SmallWhitedawsd/pulse-laser-control/README.md

# 脉冲激光控制模块

> STM32F103C8T6 实时脉冲选通器 — 从连续脉冲串中选取 N 个脉冲输出，组间延时可调。

---

## 1. 概述

本模块接收外部 **1KHz ~ 100KHz TTL 脉冲信号**，通过实时门控逻辑，按设定数量（N）选通每组脉冲，并在组间插入可调的静音延时（T）。参数通过串口设置，掉电自动保存。

### 核心功能

1. **脉冲可选（N）**：从连续脉冲串中选取 1 ~ 65535 个脉冲输出
2. **延时可调（T）**：每组脉冲之间插入 1 ~ 50000 ms 低电平静音
3. **实时跟随**：输出波形完整复制输入脉宽，输入→输出延迟 ~2μs

---

## 2. 硬件规格

| 项目 | 参数 |
|---|---|
| MCU | STM32F103C8T6 (Cortex-M3, 72MHz, 64KB Flash, 20KB SRAM) |
| 输入引脚 | **PA0** — 3.3V TTL, 内部下拉 ~10KΩ |
| 输出引脚 | **PA1** — 3.3V TTL, 推挽 50MHz, 100Ω 串联保护 |
| 串口 | **USART1** — PA9(TX) / PA10(RX), 115200-8N1 |
| USB | CH340N (Type-C) |
| 调试 | SWD — PA13(SWDIO) / PA14(SWCLK) |
| PCB | 50×25mm 直插式 |

---

## 3. 输入信号参数

| 参数 | 最小值 | 最大值 | 单位 | 说明 |
|---|---|---|---|---|
| 高电平电压 | 2.0 | 3.6 | V | TTL VIH |
| 低电平电压 | 0 | 0.8 | V | TTL VIL |
| 脉冲频率 | 1 | 100 | kHz | 周期 10μs ~ 1ms |
| 最小高电平脉宽 | 1.4 | — | μs | TIM2 @72MHz 约 100 ticks |
| 最大高电平脉宽 | — | ~910 | μs | 16 位定时器上限 |
| 输入阻抗 | — | ~10 | kΩ | 内部下拉 |

---

## 4. 输出信号参数

| 参数 | 值 | 说明 |
|---|-----|---|
| 高电平电压 | 3.3V (VOH ≥3.0V) | 推挽输出 |
| 低电平电压 | 0V (VOL ≤0.1V) | 推挽输出 |
| 输入→输出延迟 | **~2μs** | TIM2 ISR 内直驱 GPIO |
| 输出脉宽 | **= 输入脉宽** | 实时跟随，完整保留 |
| 驱动能力 | ≤25mA | 单 IO 最大 |

---

## 5. 可控参数

| 参数 | 缩写 | 范围 | 默认值 | 精度 | 说明 |
|---|---|---|---|---|---|
| 每组脉冲数 | **N** | 1 ~ N<sub>max</sub> | 2 | 1 个 | N<sub>max</sub> = 输入频率(Hz)，保证每组 ≤1 秒；无信号回退 65535 |
| 组间延时 | **T** | 1 ~ 50000 | 2 | 1 ms | 每组之间的低电平时间 |

> **N 动态上限：** TIM2 实时测量输入频率，N 最大值 = 频率值（Hz）。100KHz → N<sub>max</sub>=100000，1KHz → N<sub>max</sub>=1000。频率测量使用 32 位时间戳（TIM2 溢出中断累计），除法在主循环执行，不阻塞 ISR。

---

## 6. 串口指令

波特率 **115200**, 8 数据位, 1 停止位, 无校验, 无流控。命令以 `\r` 或 `\n` 结尾。

| 命令 | 功能 | 示例 |
|---|---|---|
| `N=<1~Nmax>` | 设置脉冲数 + 保存，上限随输入频率动态变化 | `N=5` |
| `T=<1~50000>` | 设置延时(ms) + 保存 | `T=10` |
| `N=<n> T=<t>` | 同时设置两个参数 + 保存 | `N=5 T=10` |
| `STATUS?` | 查询输入频率、当前 N/T 及 N 上限 | `STATUS?` |

### 命令响应示例

```
→ N=5 T=1
← OK N=5 T=1ms

→ STATUS?
← Fin=10000Hz N=5/10000 T=1ms   ← 10KHz 输入时 N 最大 10000

→ T=50
← OK N=5 T=50ms

→ N=20000                        ← 超过当前频率的 N 上限
← ERR N RANGE (1~10000)          ← 10KHz 输入限制 N≤10000

→ T=0
← ERR T RANGE (1~50000)
```

---

## 7. 波形示意

输入 1KHz 50% 占空比，N=2，T=1ms：

```
输入:  _|‾|_|‾|_|‾|_|‾|_|‾|_|‾|_
输出:  _|‾|_|‾|___|‾|_|‾|___|‾|_|‾|___
        p1  p2  静音 p1  p2  静音
       ← N=2 →       ← N=2 →
              ←T=1ms→       ←T=1ms→
```

---

## 8. 技术实现

### 架构

```
PA0 (输入脉冲) ──→ TIM2 双沿捕获 ──→ 实时门控状态机 ──→ PA1 (输出)
                       │                    │
                  13.9ns 分辨率        S_FORWARD: 跟随
                                      S_SILENCE: 静音 (TIM3 1ms 计时)
```

- **TIM2 ISR**：最高优先级 (0,0)，捕获 PA0 边沿，直接控制 PA1 翻转，延迟 ~2μs；同时累计溢出计数器构建 32 位时间戳，测量输入频率（ISR 内零除法开销）
- **TIM3 ISR**：优先级 (1,0)，每 1ms 溢出一次，递减静音计数器
- **主循环**：执行频率除法 `72000000/period`（Output_Poll），响应串口命令（Cmd_Poll）
- **USART1 ISR**：优先级 (2,0)，接收串口命令

### 存储

- 地址：Flash 第 63 页 `0x0800FC00`
- 内容：`burst_count` (4B) + `burst_delay` (4B)
- 首次上电：擦除态 `0xFFFFFFFF` → 使用默认值 N=2, T=2
- 触发保存：每次 `N=` 或 `T=` 命令

---

## 9. 编译与烧录

| 工具 | 版本/型号 |
|---|---|
| IDE | Keil MDK-ARM V5 |
| 库 | STM32F10x 标准外设库 V3.5.0 |
| 编译器 | ARM Compiler V5 |
| 烧录器 | ST-Link V2 / J-Link（SWD 接口） |

---

## 10. 项目结构

```
脉冲激光控制模块/
├── 脉冲激光控制模块代码/        # ← 当前版本（实时门控）
│   ├── Hardware/
│   │   ├── output.c/h           # 脉冲门控核心
│   │   ├── serial.c/h           # 串口驱动
│   │   ├── cmd.c/h              # 命令解析
│   │   ├── config.c/h           # Flash 存储
│   │   └── capture.c/h          # 保留接口
│   ├── Library/                 # STM32F10x 标准外设库
│   ├── Start/                   # 启动文件
│   └── User/                    # main.c
├── 脉冲发生器代码/               # ← 旧版（PWM 发生器，参考）
├── 上位机/                       # Python 上位机脚本
├── 0 - 客户原文.txt
├── 1 - 功能介绍.txt
├── 2 - 实现方案.md
└── 3 - 硬件选型.md
```

---

## 11. 版本历史

| 版本 | 日期 | 内容 |
|---|---|---|
| v1.0 | 2026-06-01 | 初始版本：实时门控，N/T 参数 |
| v1.1 | 2026-06-07 | 修复 TIM3 PSC 溢出、FIFO_TAG_GAP、输出 LOW 间隔 |
| v1.2 | 2026-06-08 | 修复 TIM2 16 位翻转脉宽计算、编译错误 |
| v1.3 | 2026-06-13 | 修复 5 个 Bug：静音后 CC1P 重同步、volatile 缺失、Flash 写入 TIM3 漂移、Output_Resync 停止 TIM3、删除死代码 fifo.h |
| v1.4 | 2026-06-13 | N 上限动态调整：TIM2 32 位时间戳测频 → N<sub>max</sub>=输入频率(Hz)；除法在主循环，ISR 零开销 |
