SmallWhitedawsd/pulse-laser-control/脉冲激光控制模块代码/README.md

# 脉冲激光控制模块

基于 STM32F103C8T6 的实时脉冲选通器。接收外部 1KHz~100KHz 脉冲信号，按设定数量输出每组脉冲，每组之间延时可调。

## 硬件

| 项目 | 参数 |
|---|---|
| MCU | STM32F103C8T6 (Cortex-M3, 72MHz) |
| 输入引脚 | PA0 (3.3V TTL, 内部下拉 ~10KΩ) |
| 输出引脚 | PA1 (3.3V TTL, 推挽 50MHz, 100Ω 串联保护) |
| 串口 | USART1, PA9(TX)/PA10(RX), 115200-8N1 |
| USB 芯片 | CH340N (Type-C) |
| 调试 | SWD (PA13/PA14) |
| 保护 | 输出 100Ω 限流，防外部短路 |

---

## 输入信号规格

| 参数 | 符号 | 最小值 | 典型值 | 最大值 | 单位 | 说明 |
|---|---|---|---|---|---|---|
| 高电平电压 | VIH | 2.0 | 3.3 | 3.6 | V | TTL 高电平判决门限 |
| 低电平电压 | VIL | 0 | 0 | 0.8 | V | TTL 低电平判决门限 |
| 输入频率 | Fin | 1 | — | 100 | kHz | 连续脉冲串，周期 10μs ~ 1ms |
| 最小高电平脉宽 | Tw_min | 1.4 | — | — | μs | 低于此值可能捕获不到（72MHz 下约 100 个计数） |
| 最大高电平脉宽 | Tw_max | — | — | ~910 | μs | 16 位定时器 @72MHz 上限 (65535/72) |
| 输入阻抗 | Rin | — | 10 | — | kΩ | 内部下拉电阻 |

> TIM2 捕获时钟 72MHz，每个 tick = 13.9ns，分辨率足以覆盖 1KHz~100KHz 范围。

---

## 输出信号规格

| 参数 | 符号 | 最小值 | 典型值 | 最大值 | 单位 | 说明 |
|---|---|---|---|---|---|---|
| 高电平电压 | VOH | 3.0 | 3.3 | 3.3 | V | 推挽输出 |
| 低电平电压 | VOL | 0 | 0 | 0.1 | V | 推挽输出 |
| 输入→输出延迟 | Td | — | ~2 | ~5 | μs | TIM2 ISR 入口 → GPIO 翻转 |
| 输出驱动能力 | Iout | — | — | 25 | mA | 单 IO 最大电流 |
| 高电平脉宽 | Tw_out | — | = 输入脉宽 | — | — | 实时跟随，输出脉宽 = 输入脉宽 |

> 输出采用 TIM2 ISR 内直驱 GPIO，不经过 FIFO/主循环，延迟仅 ~2μs（远低于 100KHz × 5 周期 = 50μs 约束）。

---

## 可控参数

| 参数 | 缩写 | 范围 | 默认值 | 精度 | 说明 |
|---|---|---|---|---|---|
| 每组脉冲数 | N | 1 ~ N<sub>max</sub> | 2 | 1 个脉冲 | N<sub>max</sub> = 输入频率(Hz)，保证每组 ≤1 秒；无信号回退 65535 |
| 组间延时 | T | 1 ~ 50000 | 2 | 1 ms | 每组脉冲之间的低电平静音时间 |
| 输入频率 | — | 1KHz ~ 100KHz | — | — | TIM2 32 位时间戳实时测量，STATUS? 可查 |

> **N 动态上限：** TIM2 ISR 用溢出中断累计 32 位时间戳，主循环做 `72000000/period` 除法算出频率。100KHz → N<sub>max</sub>=100000，1KHz → N<sub>max</sub>=1000。ISR 内零除法开销，不影响输出波形。

---

## 工作原理

```
外部信号 → PA0(TIM2 双沿捕获) → 实时门控 → PA1 输出
                                   │
                          ┌────────┘
                          │ 计 N 个上升沿
                          │ 第 N 个下降沿后关门
                          │ 延时 T ms 后开门
```

TIM2 捕获 PA0 上升/下降沿，ISR 内直接控制 PA1 电平：
- **门开时（S_FORWARD）**：PA1 实时跟随 PA0（延迟 ~2μs），每捕捉一个上升沿脉冲计数+1；第 N 个脉冲的下降沿后关门
- **门关时（S_SILENCE）**：PA1 保持低电平，TIM3 计数 T ms 后重新开门

---

## 串口指令

所有指令以 `\r` 或 `\n` 结尾，大小写不敏感。

| 命令 | 功能 | 示例 | 响应 |
|---|---|---|---|
| `N=<count> T=<ms>` | 同时设置脉冲数和延时，自动保存 | `N=5 T=1` | `OK N=5 T=1ms` |
| `N=<count>` | 只设置脉冲数，自动保存 | `N=3` | `OK N=3 T=1ms` |
| `T=<ms>` | 只设置延时，自动保存 | `T=10` | `OK N=3 T=10ms` |
| `STATUS?` | 查询输入频率、N/T 及 N 上限 | `STATUS?` | `Fin=10000Hz N=3/10000 T=10ms` |

### 错误响应

| 响应 | 含义 |
|---|---|
| `ERR N RANGE (1~<max>)` | N 值超出动态范围，`<max>` = 当前输入频率(Hz) |
| `ERR T RANGE (1~50000)` | T 值超出范围 |

> **注意：** 每次 `N=` 或 `T=` 命令都会自动保存到 Flash（0x0800FC00），掉电不丢失。Flash 写入约需 20ms，期间不响应串口。

### 示例

```
发送: N=5 T=1
回复: OK N=5 T=1ms

发送: STATUS?
回复: Fin=10000Hz N=5/10000 T=1ms     ← 10KHz 输入，N 最大 10000

发送: N=3
回复: OK N=3 T=1ms

发送: T=50
回复: OK N=3 T=50ms

发送: N=20000                          ← 超过频率上限
回复: ERR N RANGE (1~10000)
```

---

## 波形示意

输入 1KHz 50% 占空比，N=2，T=1ms：

```
输入:  _|‾|_|‾|_|‾|_|‾|_|‾|_|‾|_
输出:  _|‾|_|‾|___|‾|_|‾|___|‾|_|‾|___
        p1  p2 静音  p1  p2 静音
       ← N=2 →         ← N=2 →
              ← T=1ms →       ← T=1ms →
```

输入 1KHz 50% 占空比，N=3，T=5ms：

```
输入:  _|‾|_|‾|_|‾|_|‾|_|‾|_|‾|_|‾|_
输出:  _|‾|_|‾|_|‾|_____|‾|_|‾|_|‾|_____
        p1  p2  p3 静音  p1  p2  p3 静音
       ←  N=3  →          ←  N=3  →
                   ← T=5ms →        ← T=5ms →
```

---

## 定时器与中断

| 定时器 | 时钟 | 周期 | 用途 | 抢占优先级 | 子优先级 |
|---|---|---|---|:---:|:---:|
| TIM2 | 72MHz /1 | 65535 ticks | 输入脉冲双沿捕获 + 溢出累计(32位时间戳测频) | 0 | 0 |
| TIM3 | 72MHz /72 | 1000 ticks | 组间延时计时，1ms 精度 | 1 | 0 |
| USART1 | — | — | 串口命令接收 | 2 | 0 |

> TIM2 同时开启 CC1 和 Update 两个中断：CC1 捕获边沿控制输出，Update 累计 `tim2_ovf32` 构建 32 位时间戳。频率除法 `72000000/period` 在 `Output_Poll()`（主循环）中执行，ISR 零除法开销。

---

## Flash 存储

| 地址 | 内容 | 说明 |
|---|---|---|
| `0x0800FC00` | `burst_count` (4B) | 脉冲数 N，擦除态 `0xFFFFFFFF` → 使用默认值 2 |
| `0x0800FC04` | `burst_delay` (4B) | 延时 T (ms)，擦除态 `0xFFFFFFFF` → 使用默认值 2 |

- 存储页：第 63 页（最后 1KB）
- 写入触发：每次 `N=` 或 `T=` 命令
- 寿命：STM32F1 Flash ≥10,000 次擦写

---

## 编译

- **IDE**: Keil MDK-ARM V5
- **库**: STM32F10x 标准外设库 V3.5.0
- **编译器**: ARM Compiler V5
- **烧录**: ST-Link / J-Link（SWD: PA13/PA14）

---

## 文件结构

```
脉冲激光控制模块代码/
├── Hardware/
│   ├── output.c / output.h    # 脉冲门控核心（TIM2/TIM3 ISR + 状态机）
│   ├── serial.c / serial.h    # USART1 串口驱动（115200-8N1）
│   ├── cmd.c / cmd.h          # 命令解析（N= / T= / STATUS?）
│   ├── config.c / config.h    # Flash 持久化配置
│   └── capture.c / capture.h  # 保留接口（未使用）
├── Library/                    # STM32F10x 标准外设库
├── Start/                      # 启动文件 + 系统时钟
└── User/
    ├── main.c                  # 主函数
    ├── stm32f10x_conf.h       # 外设配置头
    └── stm32f10x_it.c/h       # 异常向量表
```
