SmallWhitedawsd/pulse-laser-control/3 - 硬件选型.md

### 第一部分：Type-C 母座的连线

1. **VBUS 引脚**：连到 5V 电源线上去（也就是连到稳压芯片的输入端）。✅
2. **GND 引脚**：连到板子的地线。✅
3. **CC1 引脚**：连一个 5.1K 的电阻，电阻的另一头接地。✅
4. **CC2 引脚**：连另一个独立的 5.1K 的电阻，电阻的另一头接地。（千万别和 CC1 共用电阻）✅
5. **DP1 和 DP2 引脚**：这两个脚短接在一起，连到 **CH340N 的第 1 脚 (UD+)**。✅
6. **DN1 和 DN2 引脚**：这两个脚短接在一起，连到 **CH340N 的第 2 脚 (UD-)**。✅
7. **SBU1 和 SBU2 引脚**：空着，什么都不用连。✅

### 第二部分：CH340N 串口芯片的连线 (配合 3.3V 系统)

1. **第 5 脚 (VCC) 和 第 8 脚 (V3)**：这两个脚连在一起，全都接到 3.3V 电源上。✅
2. **第 3 脚 (GND)**：连到板子的地线。✅
3. **第 1 脚 和 第 2 脚**：分别接刚才 Type-C 引过来的 DP (D+) 和 DN (D-) 数据线。✅
4. **第 6 脚 (TXD)**：连到单片机的 **PA10 (RX)** 引脚。✅
5. **第 7 脚 (RXD)**：连到单片机的 **PA9 (TX)** 引脚。✅
6. **第 4 脚 (RTS#)**：空着，不用连。✅

### 第三部分：STM32 单片机的核心连线

1. **PA9 (TX)**：连到 CH340N 的 **第 7 脚 (RXD)**。✅
2. **PA10 (RX)**：连到 CH340N 的 **第 6 脚 (TXD)**。✅
3. **PA0**：连你的脉冲输入信号，同时在这个脚上接一个 10K 的电阻，电阻另一头接地。✅
4. **PA1**：连你的脉冲输出设备。✅
5. **四个 VDD 电源脚**（9脚、24脚、36脚、48脚）：全都连到 3.3V，每个脚旁边必须放一个 0.1uF 的小电容接地。✅
6. **四个 VSS 地线脚**（8脚、23脚、35脚、47脚）：全都连到地线。✅
7. **BOOT0 脚 和 BOOT1（PB2）脚**：各接一个 10K 电阻接地。✅
8. **VBAT (1脚)**：连到 3.3V。✅
9. **外部 8MHz 晶振**：晶振两端分别连第 5 脚 (OSC_IN) 和 第 6 脚 (OSC_OUT)，并且在这两个脚上各接一颗 22pF 电容到地线。✅
10. **SWD 程序烧录接口**：准备一个 4 针排针，第 34 脚 (PA13) 连 SWDIO，第 37 脚 (PA14) 连 SWCLK。排针另外两根连 3.3V 和 GND。✅

### 第四部分：BNC 脉冲输入接口连线 (BNC-KYWE-295-W4-N)

1. **第 5 脚 (中心信号线)**：直接连到单片机的 **PA0** 引脚。✅
2. **10K 防抖下拉电阻**：一头连在 **PA0 (或 BNC 的第 5 脚)**，另一头连到 **地线 (GND)**。（在物理走线上，这三者交汇在同一个节点）。✅
3. **第 1、2、3、4 脚 (外壳屏蔽脚)**：全部连到板子的 **地线 (GND)**。为了发挥最佳的高频抗干扰屏蔽效果，建议在这4个引脚的焊盘处直接打大过孔，牢牢连入底层的地铜网络。✅

### 第五部分：脉冲输出端子连线 (WJ500V-5.08-2P) 

1. **Pin 1 (输出信号)**：连到单片机的 PA1 引脚。引脚和端子之间串联一颗 100Ω 贴片电阻，防止外部设备短路烧毁单片机。✅
2. **Pin 2 (公共地)**：连到板子的 地线 (GND)。✅
