SmallWhitedawsd/pulse-laser-control/功能系统图.jpg

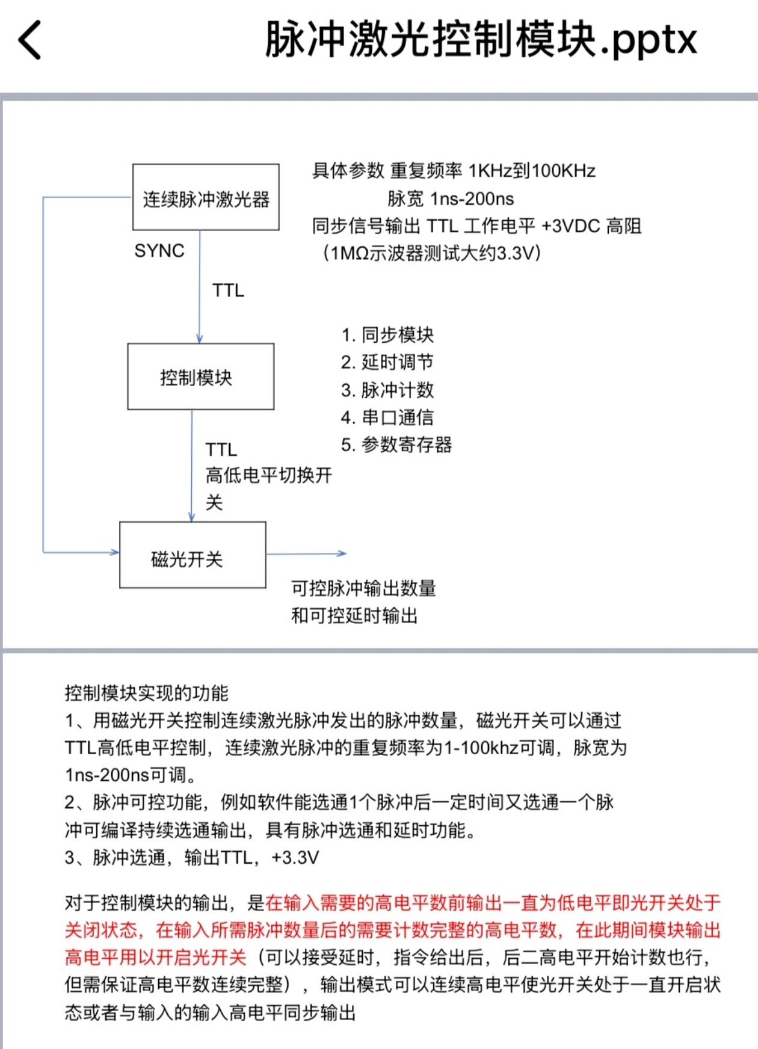
功能系统图.jpg
