SmallWhitedawsd/pulse-laser-control/BOM_Board1_Schematic1_2026-06-01.xlsx

No. | Quantity | Comment | Designator | Footprint | Value | Manufacturer Part | Manufacturer | Supplier Part | Supplier | 金额 |  | 数量
1 | 2 | 100nF | C2,C4 | C0603 | 100nF | CL10B104KB8NNNC | SAMSUNG(三星) | C1591 | LCSC |  | 有
2 | 1 | 10uF | C3 | C0603 | 10uF | CL10A106KP8NNNC | SAMSUNG(三星) | C19702 | LCSC |  | 有
3 | 4 | 100nF | C5,C6,C7,C8 | C0603 | 100nF | GRM188R71H104KA93D | muRata(村田) | C77055 | LCSC |  | 有
4 | 2 | 22pF | C11,C12 | C0603 | 22pF | CL10C220JB8NNNC | SAMSUNG(三星) | C1653 | LCSC |  | 有
5 | 1 | ZX-XH2.54-4PWZ | H2 | CONN-TH_4P-P2.50_ZX-XH2.54-4PWZ |  | ZX-XH2.54-4PWZ | Megastar(兆星) | C7429643 | LCSC |  | 不用买
6 | 1 | WJ500V-5.08-2P | P1 | CONN-TH_2P-P5.00_WJ500V-5.08-2P |  | WJ500V-5.08-2P | KANGNEX(康奈克斯电气) | C8465 | LCSC | 3.38 |  | 10
7 | 2 | 5.1kΩ | R1,R2 | R0603 | 5.1kΩ | 0603WAF5101T5E | UNI-ROYAL(厚声) | C23186 | LCSC | 3 |  | 100
8 | 3 | 10kΩ | R3,R4,R5 | R0603 | 10kΩ | FRC0603J103 TS | FOJAN(富捷) | C2930027 | LCSC |  | 有
9 | 1 | 3GHz | RF1 | BNC-TH_BNC-KYWE-295-W4-N | 3GHz | BNC-KYWE-295-W4-N | SAMZO(三佐) | C41416668 | LCSC | 3.1 |  | 1
10 | 4 | M2螺丝 | SCREW1,SCREW2,SCREW3,SCREW4 | M2螺丝 |  |  |  |  |  |  | 不用买
11 | 1 | STM32F103C8T6 | U1 | LQFP-48_L7.0-W7.0-P0.50-LS9.0-BL |  | STM32F103C8T6 | ST(意法半导体) | C8734 | LCSC | 14 |  | 2
12 | 1 | AMS1117-3.3 | U4 | SOT-223-3_L6.5-W3.4-P2.30-LS7.0-BR |  | AMS1117-3.3 | AMS | C6186 | LCSC |  | 有
13 | 1 | HC-TYPE-C-16P-3M2S | U5 | USB-C-SMD_HC-TYPE-C-16P-026W |  | HC-TYPE-C-16P-3M2S | HC(虹成电子) | C19274016 | LCSC |  | 已买
14 | 1 | CH340N | U6 | SOP-8_L4.9-W3.9-P1.27-LS6.0-BL |  | CH340N | WCH(南京沁恒) | C2977777 | LCSC | 3.61 |  | 2
15 | 1 | 8MHz | X2 | CRYSTAL-SMD_L5.0-W3.2 | 8MHz | X50328MSB2GI | YXC(扬兴晶振) | C115962 | LCSC |  | 有
 |  |  |  |  |  |  |  |  | 共计 | 27.09
 |  | 已购买 | 未购买 | 不清楚
