SmallWhitedawsd/pulse-laser-control/硬件资料/BNC母头.PDF

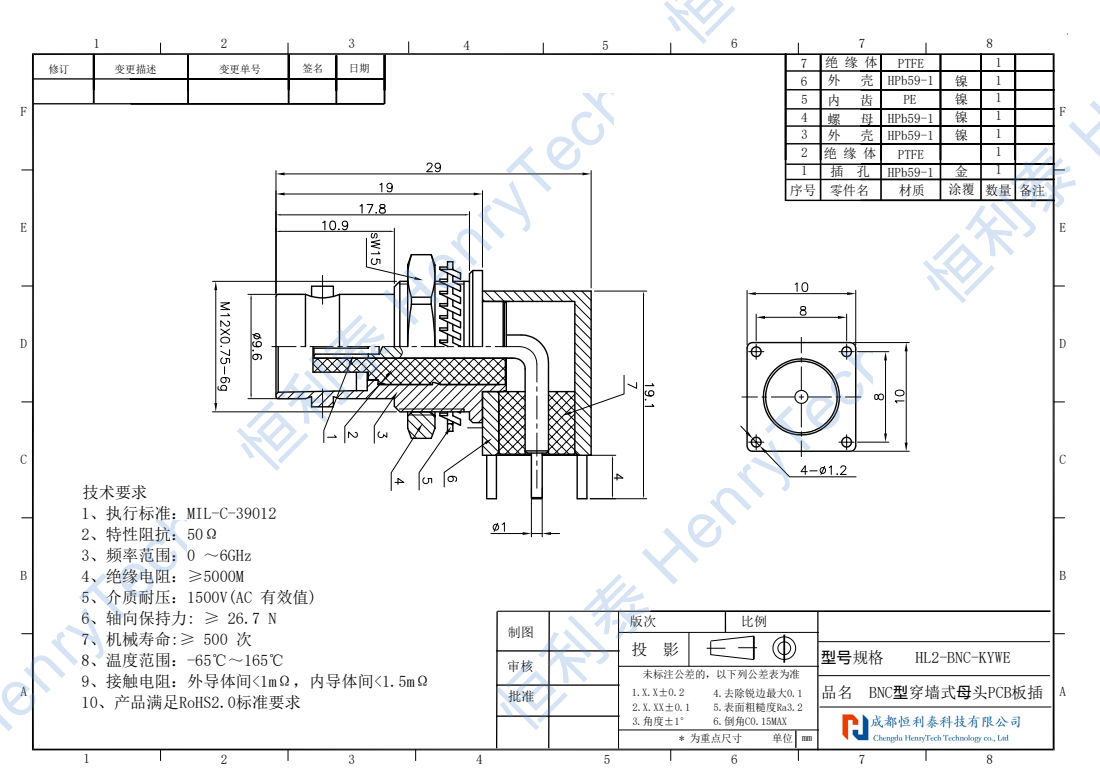
[picture p2: page 1]
未标注公差的，以下列公差表为准; * 为重点尺寸; 4.去除锐边最大0.1 5.表面粗糙度Ra3.2 6.倒角C0.15MAX; 型号规格; HL2-BNC-KYWE; BNC型穿墙式母头PCB板插; 变更描述; 变更单号; 零件名; HPb59-1; PTFE; PTFE HPb59-1 材质; 技术要求 1、执行标准：MIL-C-39012 2、特性阻抗：50Ω 3、频率范围：0 ～6GHz 4、绝缘电阻：≥5000M 5、介质耐压：1500V(AC 有效值) 6、轴向保持力: ≥ 26.7 N 7、机械寿命:≥ 500 次 8、温度范围：-65℃～165℃ 9、接触电阻：外导体间<1mΩ，内导体间<1.5mΩ 10、产品满足RoHS2.0标准要求; 恒利泰 HenryTech

恒利泰 HenryTech
