SmallWhitedawsd/pulse-laser-control/脉冲激光控制模块代码/Hardware/output.c

/* output.c — real-time pulse gate
 *
 * PA0 ← input signal, PA1 → output. TIM2 ISR directly mirrors PA0 → PA1.
 *
 * Gate: S_FORWARD → follow edges. After burst_count pulses → S_SILENCE.
 *       S_SILENCE → hold PA1 LOW, TIM3 counts burst_delay ms, then → S_FORWARD.
 */

#include "output.h"

volatile uint32_t burst_count = 2;
volatile uint32_t burst_delay = 2;
volatile uint32_t input_freq_hz = 0;      /* computed in Output_Poll from raw_period_ticks */
volatile uint32_t raw_period_ticks = 0;   /* ISR stores period between rising edges (72MHz ticks) */

static volatile uint32_t pulse_cnt;
static volatile uint32_t tim3_ms;

/* frequency measurement — ISR side (no division, 32-bit timestamps via ovf counter) */
static volatile uint32_t tim2_ovf32;       /* TIM2 overflow counter for 32-bit timestamp */
static volatile uint32_t prev_ts32;        /* previous rising-edge 32-bit timestamp */
static volatile uint8_t  prev_rise_valid;

typedef enum { S_FORWARD, S_SILENCE } gate_t;
static volatile gate_t gate = S_FORWARD;

void Output_Init(void)
{
	RCC_APB2PeriphClockCmd(RCC_APB2Periph_GPIOA, ENABLE);

	GPIO_InitTypeDef g = {0};
	g.GPIO_Mode  = GPIO_Mode_IPD;
	g.GPIO_Pin   = GPIO_Pin_0;
	GPIO_Init(GPIOA, &g);

	g.GPIO_Mode  = GPIO_Mode_Out_PP;
	g.GPIO_Pin   = GPIO_Pin_1;
	g.GPIO_Speed = GPIO_Speed_50MHz;
	GPIO_Init(GPIOA, &g);
	GPIO_ResetBits(GPIOA, GPIO_Pin_1);

	RCC_APB1PeriphClockCmd(RCC_APB1Periph_TIM2, ENABLE);
	TIM_TimeBaseInitTypeDef t = {0};
	t.TIM_Period    = 65535;
	t.TIM_Prescaler = 0;
	t.TIM_CounterMode = TIM_CounterMode_Up;
	TIM_TimeBaseInit(TIM2, &t);

	TIM_ICInitTypeDef ic = {0};
	ic.TIM_Channel     = TIM_Channel_1;
	ic.TIM_ICPolarity  = TIM_ICPolarity_Rising;
	ic.TIM_ICSelection = TIM_ICSelection_DirectTI;
	ic.TIM_ICPrescaler = TIM_ICPSC_DIV1;
	TIM_ICInit(TIM2, &ic);
	TIM_ITConfig(TIM2, TIM_IT_CC1, ENABLE);
	TIM_ITConfig(TIM2, TIM_IT_Update, ENABLE);   /* for 32-bit overflow counting */

	NVIC_InitTypeDef n = {0};
	n.NVIC_IRQChannel    = TIM2_IRQn;
	n.NVIC_IRQChannelCmd = ENABLE;
	n.NVIC_IRQChannelPreemptionPriority = 0;
	n.NVIC_IRQChannelSubPriority = 0;
	NVIC_Init(&n);

	RCC_APB1PeriphClockCmd(RCC_APB1Periph_TIM3, ENABLE);
	t.TIM_Period    = 1000 - 1;
	t.TIM_Prescaler = 72 - 1;
	TIM_TimeBaseInit(TIM3, &t);
	TIM_ITConfig(TIM3, TIM_IT_Update, ENABLE);

	n.NVIC_IRQChannel    = TIM3_IRQn;
	n.NVIC_IRQChannelPreemptionPriority = 1;
	n.NVIC_IRQChannelSubPriority = 0;
	NVIC_Init(&n);

	TIM_ClearITPendingBit(TIM2, TIM_IT_CC1);
	TIM_Cmd(TIM2, ENABLE);
}

void Output_Poll(void)
{
	/* compute frequency from raw period (expensive 32-bit division, done here not in ISR) */
	uint32_t p = raw_period_ticks;
	if (p > 0) {
		input_freq_hz = 72000000UL / p;
	}
}

void Output_Resync(void)
{
	TIM_Cmd(TIM3, DISABLE);          /* stop gap timer if running */
	gate = S_FORWARD;
	pulse_cnt = 0;
	GPIO_ResetBits(GPIOA, GPIO_Pin_1);
	if (GPIO_ReadInputDataBit(GPIOA, GPIO_Pin_0))
		TIM2->CCER |= TIM_CCER_CC1P;
	else
		TIM2->CCER &= ~TIM_CCER_CC1P;
	TIM_ClearITPendingBit(TIM2, TIM_IT_CC1);
}

/* ========== ISRs ========== */

void TIM2_IRQHandler(void)
{
	/* handle overflow first — keeps tim2_ovf32 up-to-date for CC1 timestamp */
	if (TIM_GetITStatus(TIM2, TIM_IT_Update) != RESET) {
		TIM_ClearITPendingBit(TIM2, TIM_IT_Update);
		tim2_ovf32++;
	}

	if (TIM_GetITStatus(TIM2, TIM_IT_CC1) != RESET) {
		TIM_ClearITPendingBit(TIM2, TIM_IT_CC1);
		uint16_t ccr = TIM_GetCapture1(TIM2);
		uint32_t cur_ts = ((uint32_t)tim2_ovf32 << 16) | ccr;

		if (TIM2->CCER & TIM_CCER_CC1P) {
			if (gate == S_FORWARD && pulse_cnt > 0) {
				GPIO_ResetBits(GPIOA, GPIO_Pin_1);
				if (pulse_cnt >= burst_count) {
					gate = S_SILENCE;
					pulse_cnt = 0;
					tim3_ms = burst_delay;
					TIM3->CNT = 0;
					TIM_ClearITPendingBit(TIM3, TIM_IT_Update);
					TIM_Cmd(TIM3, ENABLE);
				}
			}
		} else {
			/* 32-bit period between rising edges (no division in ISR) */
			if (prev_rise_valid) {
				uint32_t period = cur_ts - prev_ts32;
				/* valid range: 720 ticks (100KHz) ~ 72000 ticks (1KHz) */
				if (period >= 720 && period <= 72000) {
					raw_period_ticks = period;
				}
			}
			prev_ts32 = cur_ts;
			prev_rise_valid = 1;

			if (gate == S_FORWARD) {
				pulse_cnt++;
				GPIO_SetBits(GPIOA, GPIO_Pin_1);
			}
		}
		TIM2->CCER ^= TIM_CCER_CC1P;
	}
}

void TIM3_IRQHandler(void)
{
	if (TIM_GetITStatus(TIM3, TIM_IT_Update) != RESET) {
		TIM_ClearITPendingBit(TIM3, TIM_IT_Update);
		if (tim3_ms) {
			tim3_ms--;
			if (tim3_ms == 0) {
				TIM_Cmd(TIM3, DISABLE);
				gate = S_FORWARD;
				/* resync edge polarity with current input level */
				if (GPIO_ReadInputDataBit(GPIOA, GPIO_Pin_0))
					TIM2->CCER |= TIM_CCER_CC1P;
				else
					TIM2->CCER &= ~TIM_CCER_CC1P;
			}
		}
	}
}
