SmallWhitedawsd/pulse-laser-control/脉冲激光控制模块代码/Hardware/Serial.h

/* serial.h - USART1 115200 8N1 */

#ifndef __SERIAL_H
#define __SERIAL_H

#include "stm32f10x.h"

extern volatile uint8_t uart_rx_data;
extern volatile uint8_t uart_rx_flag;

void UART_Init(void);
void UART_SendByte(uint8_t b);
void UART_SendStr(const char *s);
void UART_Printf(const char *fmt, ...);

#endif
