SmallWhitedawsd/pulse-laser-control/(commit log)

2026-06-06 feat: 精简为纯串口回显实验 + spec-kit 9技能
    - Serial.c: 增加 PA10 RX 浮空输入 + RXNE 中断 + NVIC 配置，收发模式
    - stm32f10x_it.c: 新增 USART1_IRQHandler 回显
    - main.c: 精简为仅串口初始化 + 欢迎信息
    - 删除 OLED/LED/Key/Delay 无关文件
    - 更新 Project.uvprojx 工程文件
    - 添加 spec-kit 9个 SDD 技能 (constitution/specify/plan/tasks/implement/clarify/analyze/checklist/taskstoissues)
    [BOM_Board1_Schematic1_2026-06-01.xlsx]
2026-06-06 引脚本方案: PA6→PA0 输入, PA7→PA1 输出 (TIM2捕获/TIM3间隙/TIM4脉宽)
2026-06-06 feat: FIFO环形缓冲架构 — 完整脉冲激光控制模块
    v2 实现:
    - TIM2_CH1 输入捕获 (PA0), 双沿捕获, 首脉冲直通旁路 <0.3μs
    - TIM4 脉宽输出定时器 (1μs 分辨率), 控制 PA1 高电平
    - TIM3 间隙等待定时器 (1ms 分辨率), 控制 PA1 低电平间隙
    - 消费者状态机: IDLE → PULSE_OUT → GAP_WAIT
    - FIFO 环形队列 1024深度, 位与替代取模
    - UART 命令解析 (GAP=, GAP?, SAVE, STATUS?, HELP)
    - Flash 参数存储 (最后一页 0x0800FC00)
    - USART1 115200 8N1, 中断优先级按方案配置
2026-06-06 feat: 脉冲发生器 — 测试辅助工具
    PA6(TIM3_CH1 PWM)输出, 串口设置参数:
    - FREQ=xxx 脉冲频率 1000~100000Hz
    - DUTY=xx 占空比 1~99%
    - PULSES=N 每轮脉冲数 1~500
    - START/STOP 启停控制
    - STATUS? 查询状态
    TIM2 每隔5秒触发一轮, TIM3 精确计数 N 个脉冲后自动停止
    用于测试脉冲激光控制模块的 PA0 输入
2026-06-07 fix: 脉冲发生器串口测试通过, 修复TIM2上电不启动
    - main.c + Serial.c 恢复为完整发生器版本
    - TIM2改为START命令后才启动 (之前上电即启导致卡死)
    - USART 115200 8N1 收发验证OK
    [Serial.c, main.c]
2026-06-07 fix: Generator_Init延迟激活 — 上电只跑串口, START才配定时器
    - Generator_Init() 改为空函数, 定时器硬件初始化推迟到 START 时
    - 彻底避免上电时 TIM2/TIM3 冲突导致串口无响应
2026-06-07 fix: 单文件main.c自包含 — 消除交叉依赖导致的卡死
    - 所有代码合并到 main.c (UART + 命令 + 发生器 + ISR)
    - Serial.c 清空 (避免重复 ISR)
    - 定时器延迟到 START 时才初始化
    - 已验证: echo模式下串口115200正常
    [Serial.c, main.c]
2026-06-07 feat: 脉冲发生器串口输出全面中文化
2026-06-07 fix: main.c转为GBK编码, 串口中文不乱码
2026-06-07 fix: 回退为纯英文ASCII, UTF-8编码, 修复GBK导致命令解析失败
    [main.c]
2026-06-07 feat: 间隔从5秒改为1秒
2026-06-07 feat: 一条命令设置全部参数 F=10000 D=50 N=10
    新增组合命令格式: F=频率 D=占空比 N=脉冲数, 空格分隔
    旧的单条命令 FREQ=/DUTY=/PULSES= 仍然可用
2026-06-07 feat: START F=1000 D=50 N=10 一条命令设参+启动
    支持: START F=1000 D=50 N=10 (设参并立即启动)
    也支持: F=1000 D=50 N=10 START (同样效果)
    纯 START 依然生效
2026-06-07 fix: PA6空闲强制低电平, START恢复PWM; 上电初始低
    - main() 初始PA6为Out_PP低电平
    - STOP/本轮结束 用TIM_ForcedOC1Config强制PA6低
    - START/新轮开始 恢复PWM1模式
    [main.c]
2026-06-07 fix: sscanf从F=位置开始扫描, 修复START F=...命令识别
    之前sscanf从cmd_buf开头匹配F=, START在前面对不上
    [main.c]
2026-06-07 feat: 支持100KHz高频 + T=间隔参数 + N上限100000
    - PWM计算: 最小ARR≥200保证高频稳定
    - T= 设置轮间间隔秒数(1~3600)
    - N上限从500提到100000
    - 命令解析改用逐个参数提取, 任意顺序
2026-06-07 fix: CC1比较中断计数脉冲, 末脉冲不再瘦
    - TIM3改用CC1(比较匹配)计数, CC1在输出翻低时触发
    - 第N个脉冲在LOW自然截止, 无强制拉低尾迹
    - 解决100KHz下最后脉冲高电平被截断的问题
    - STOP保留强制拉低确保空闲安全
    [main.c]
2026-06-07 fix: 控制模块TIM2延迟启动, 避免浮空PA0误触发ISR卡死
    - Timer2_Capture_Init() 不再使能TIM2计数器
    - 新增 Timer2_Capture_Enable() 在发完欢迎信息后调用
    - 解决上电PA0浮空触发CC1中断导致串口无响应
    [main.c]
2026-06-07 fix: GAP下限从1000ms降到100ms+防零间隙卡死
    - uart_cmd.c: GAP有效范围100~50000ms
    - timer3_gap.c: deadtime_start零值保护防止计数器溢出
    - 配合发生器1KHz 5脉冲/秒可实时同步输出
2026-06-07 fix: GAP范围改为1~50000ms(1ms步进), 默认100ms
    - uart_cmd.c: 下限从100ms降到1ms
    - state_machine.c: 默认间隔从5s改为100ms
    - param_store.c: Flash默认值同步改为100ms
    - 配合发生器1KHz 5脉冲可实时输出
2026-06-07 fix: GAP下限真正改为1ms (之前只改到100)
2026-06-07 feat: TEST命令 — PA1输出1Hz方波不依赖外部输入
    - state_machine: test_mode标志, start_test_output/stop_test_output
    - TIM3 ISR: test模式自动翻转PA1, 1Hz/50%占空比
    - TIM2 ISR: test模式屏蔽输入捕获
    - uart_cmd: TEST/STOPTEST命令, HELP/STATUS适配
2026-06-07 revert: 移除TEST测试模式, 恢复纯脉冲控制
    - state_machine: 删除test_mode/start_test_output/stop_test_output
    - timer3_gap: 恢复原始间隙ISR
    - timer2_capture: 移除test_mode拦截
    - uart_cmd: 恢复原始5命令(无TEST/STOPTEST)
2026-06-07 fix: 移除首脉冲直通旁路 — N脉冲全量入FIFO不出丢
    之前5脉冲进→旁路吃掉第1个→只有4个进FIFO→输出少1个
    现在全部脉冲入FIFO, 消费者统一出队输出, N进=N出
2026-06-07 fix: TIM2输入刻度(72MHz)转换为μs再入FIFO
    之前FIFO存的是原始72MHz计时器刻度(1tick=13.9ns),
    消费者调用Timer4_Start_us(1MHz=1μs)将其错误解释为μs,
    导致输出脉宽放大72倍。现ISR中÷72转换后入队。
2026-06-07 fix: PA0改为下拉输入+FIFO复位, 彻底解决浮空噪声填充
    - PA0 GPIO_Mode_IPD 替代 IN_FLOATING, 防浮空噪点触发ISR
    - Timer2_Capture_Enable() 清零FIFO指针+TIM2计数器+CC1挂起位
    - 确保上电后FIFO完全干净, 只响应真实脉冲输入
2026-06-07 feat: LED闪灯+输出计数STATUS, 直观验证每脉冲输出
    - PA1输出高/低时LED(POC13)同步亮/灭, 肉眼可见
    - STATUS?新增OUT=计数, 验证N脉冲=5时OUT=5
    - 精简状态显示: I(IDLE)/P(PULSE_OUT)/W(GAP_WAIT)
2026-06-07 refactor: 完全重构 — 5文件，极简架构
    capture.c — TIM2_CH1 PA0双沿捕获，/72转μs入fifo
    output.c — TIM4脉宽(1μs)+TIM3间隙(1ms)+状态机
    cmd.c — UART命令(GAP=,GAP?,SAVE,STATUS?,HELP)
    fifo.h — 1024环形缓冲，inline函数
    serial.c — USART1 115200 8N1
    流程: 输入→测高宽→入队→消费(复刻高宽+间隙)→输出
    PA0=下拉防浮空, PA1=推挽输出, 中断全解耦
2026-06-07 fix: 编译错误 — serial.h用stm32f10x.h, 72000UL防截断
    [Serial.c, Serial.h, output.c]
2026-06-07 fix: TIM2 16位翻转导致脉宽算错 — 强制无符号运算
    uint16_t now - start 在C中提升为有符号int,
    计数器卷绕时得负数/72→大正数→TIM4输出65ms。
    改为(uint16_t)(now-start)/72U 强制无符号环绕。
2026-06-07 fix: TIM3 PSC overflow (72000>65535); add FIFO_TAG_GAP; output uses gap_ms for LOW interval
    [main.c, output.c]
2026-06-07 初步完成任务，延迟待优化
2026-06-13 添加上位机代码、README和硬件资料；更新项目文件
2026-06-13 fix: 修复5个Bug + 完善README输入输出参数文档
    Bug修复:
    - output.c: 静音结束后重同步CC1P边沿极性，消除首脉冲相位错误
    - output.c: Output_Resync中停止TIM3，防止静音定时器干扰
    - serial.c/h: uart_rx_data/flag加volatile，修复编译器优化导致死循环
    - config.c: Flash写入前暂停TIM3、写入后恢复，避免计时器漂移
    - fifo.h: 删除未使用的死代码
    文档更新:
    - 根目录README: 重写为当前实际门控方案，补全输入/输出参数、指令集、波形图
    - 代码目录README: 补充完整输入信号规格、输出信号规格、波形示意图、文件结构
    [Serial.c, Serial.h, config.c, output.c]
2026-06-13 feat: N上限根据输入频率动态调整，上限=频率(Hz)，保证每组≤1秒
    - output.c: TIM2 ISR上升沿测量输入频率(period→Hz)，处理16位溢出
    - output.h: 导出input_freq_hz供cmd.c使用
    - cmd.c: n_max()根据实时频率计算N上限; STATUS?显示Fin/Nmax
    - README: 更新N动态范围说明和命令响应示例
    100KHz→Nmax=100000, 1KHz→Nmax=1000, 无信号→回退65535
2026-06-13 Revert "feat: N上限根据输入频率动态调整，上限=频率(Hz)，保证每组≤1秒"
    This reverts commit 4903403b8fd0373c9898c81dfbaaaf8f3e35a9f1.
    [cmd.c, output.c, output.h]
2026-06-13 feat: 动态N上限(修复版) — 除法移到主循环，ISR零开销
    ISR只存raw_period_ticks(3条整数指令)，Output_Poll做32位除法。
    100KHz输入时Nmax=100000，1KHz时Nmax=1000，无信号回退65535。
    与上一版的区别：72000000UL/period 从ISR移到main loop，不再阻塞边沿捕获。
    [cmd.c, output.c, output.h]
2026-06-13 fix: 频率测量修复 — TIM2溢出中断构建32位时间戳，解决1KHz误读
    根因: 1KHz周期=72000ticks>65535(16位), ccr>=prev分支误判无翻转
    修复: TIM2 Update中断累计tim2_ovf32, 上升沿构建cur_ts=(ovf<<16)|ccr,
    period=cur_ts-prev_ts32, 32位减法天然处理任意次翻转
    有效性检查: period 720~72000 ticks (1KHz~100KHz), 滤除异常值
    [output.c]
2026-06-13 docs: README同步v1.4 — N动态上限、频率测量、STATUS?新格式
    - N范围改为1~Nmax(动态=输入频率Hz)
    - STATUS?响应示例: Fin=10000Hz N=5/10000 T=1ms
    - ERR N RANGE示例: ERR N RANGE (1~10000)
    - 技术实现补充32位时间戳测频说明
    - 定时器表: TIM2增加Update中断累计ovf32
    - 版本历史增加v1.4
